danpeirce/photogate-box-ssd1306term/image/boards-mounted-bracket.jpg

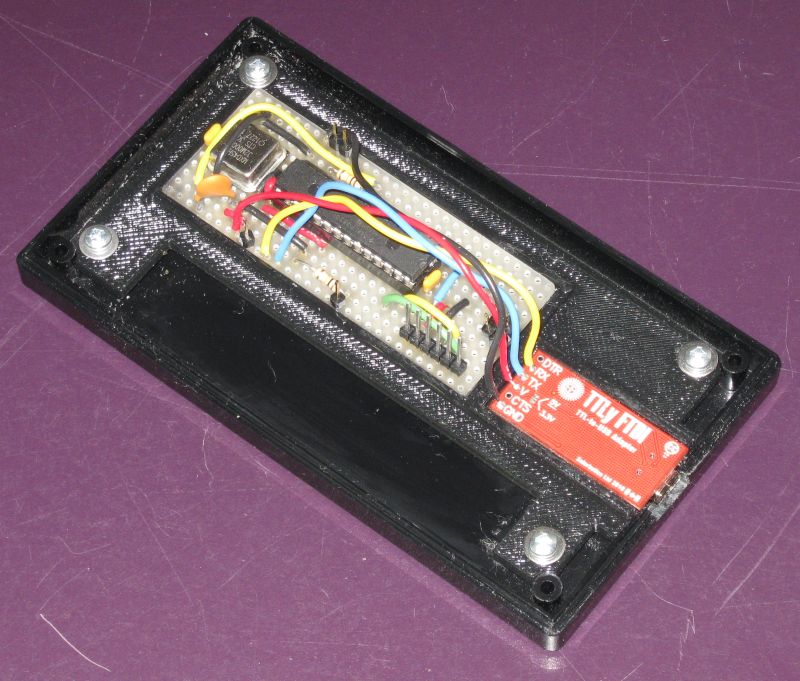
image/boards-mounted-bracket.jpg
