danpeirce/photogate-box-ssd1306term/image/keypress.jpg

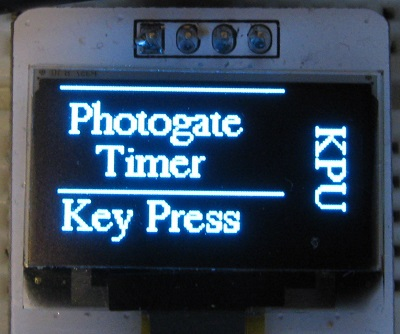
image/keypress.jpg
