danpeirce/photogate-box-ssd1306term/image/keyrelease.jpg

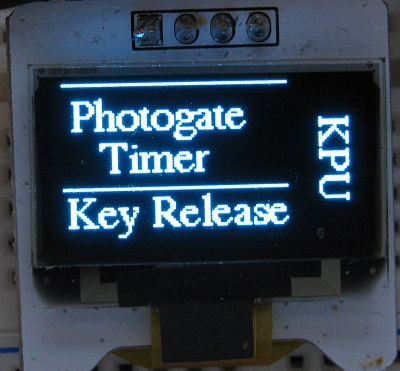
image/keyrelease.jpg
