danpeirce/photogate-box-ssd1306term/image/mancyclemode-s.png

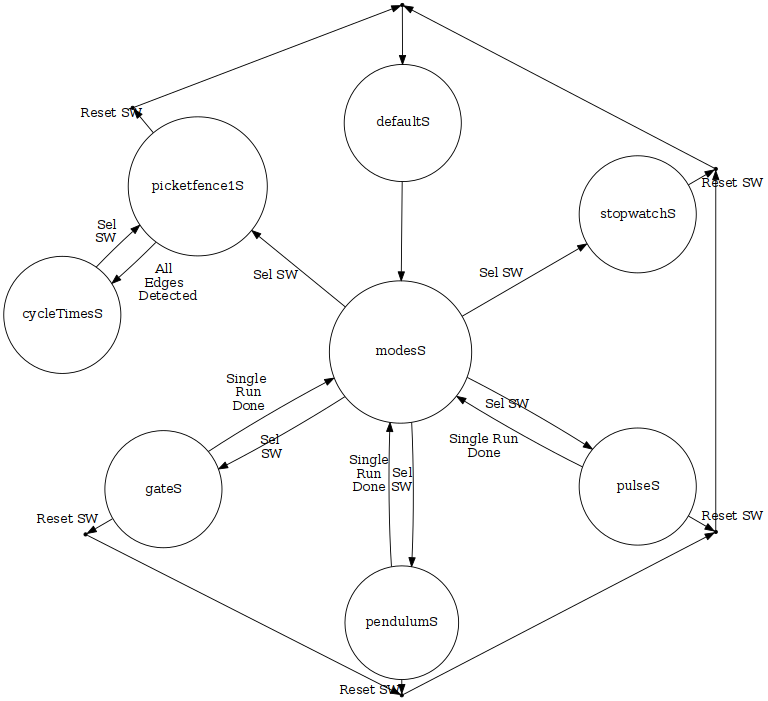
image/mancyclemode-s.png
