danpeirce/photogate-box-ssd1306term/image/mancyclemode.png

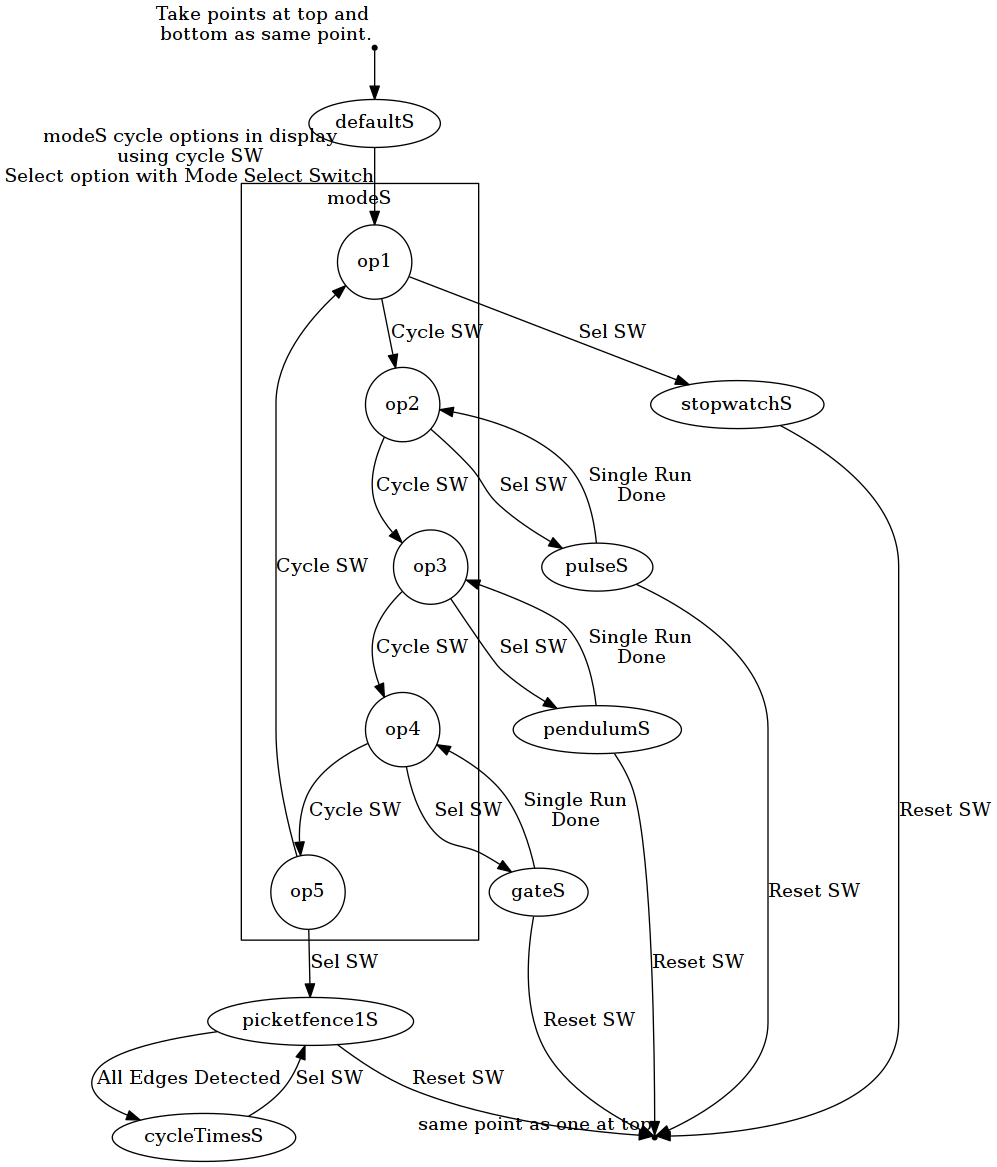
image/mancyclemode.png
