danpeirce/photogate-box-ssd1306term/image/terminal-in-box.jpg

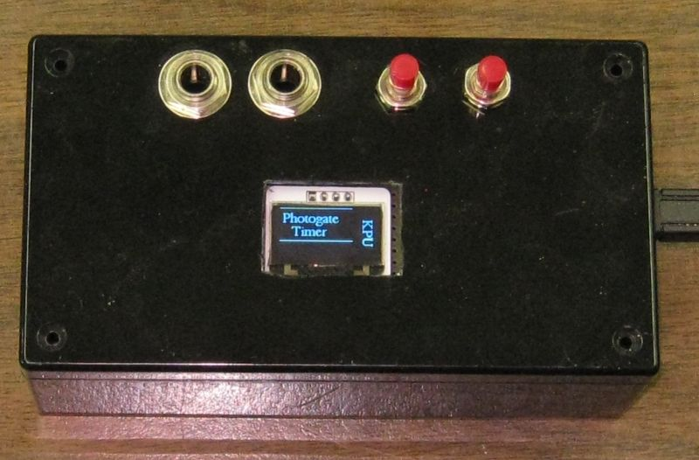
image/terminal-in-box.jpg
