danpeirce/photogate-box-ssd1306term/image/timeswitchsec.jpg

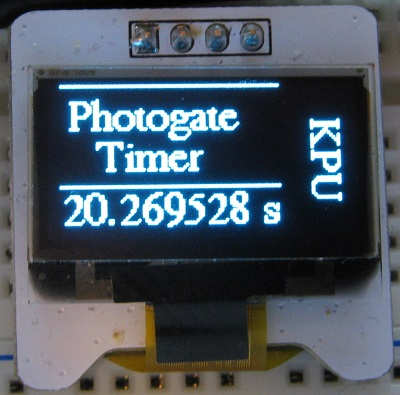
image/timeswitchsec.jpg
