danpeirce/photogate-box-ssd1306term/image/board_test01.jpg

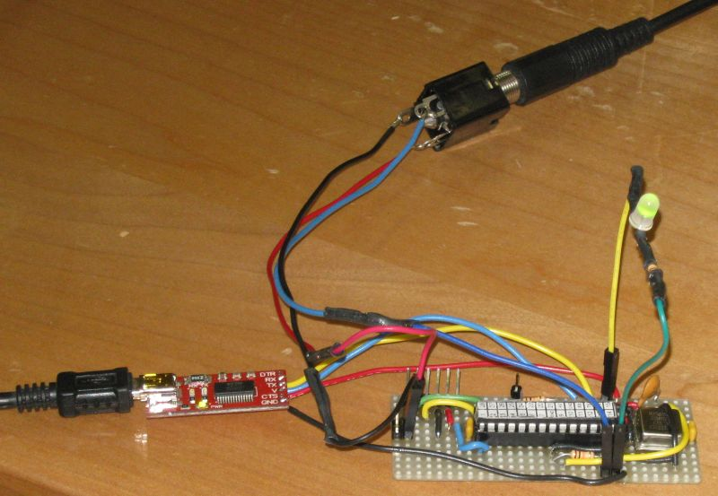
image/board_test01.jpg
