danpeirce/photogate-box-ssd1306term/(commit log)

2014-06-14 Moved LED outputs from Port D (wich does not exist) to port C
2014-06-14 Added image of board to readme.md
2014-06-16 Correction to PhotogateLV.c comments.
    Corrected pin numbers for CCP1 and CCP2 (the old numbers were for the PIC18F4525).
2014-06-16 new file pic18f2620.txt shows pin assignments
2014-06-23 modified: PhotogateLV.c on branch bugfix-timer
    Functions modified to use Timer1 and not Timer3
    * Time_AllEdges_2Gates()
    * Time_FallingEdges_2Gates()
    * C12_Increment_Counter_on_Timer_Rollover()
    The theory is the bug is as a result of Counter being
    incremented by both timers. It is not necessary to have
    more than one counter with both CPP modules as long as
    only one time scale is needed.
    The symtom was getting times reported as about twice they
    should have been when both CCP's were being used
    (like for the collision timer).
2014-06-27 Added photo to README.md
    Added photo of mounting plate used to attach the PCB's to the box lid.
2014-07-01 new files: host/nameVirtualCOM.py and host/photogate-timer.py
2014-07-01 modified: host/photogate-timer.py
    This file is still a work in progrss
    It does not do much yet!
2014-07-02 modified: photogate-timer.py reports time in seconds
2014-07-02 modified: doc/Time_AllEdges_1Gate.md
    Added link to photogate-timer.py
2014-07-06 modified: README.md - gate1.py - gate1_IPython.txt
    deleted: photogate-timer.py
    Note that ser.timeout = 0 so that reads from port are non blocking.
2014-07-10 modified: host/gate1gui.pyw
    Added run and exit buttons to GUI
2014-07-13 Moved images into repository
    modified: README.md
    new file: image/board_test01.jpg
    new file: image/box-gate.jpg
2014-07-13 modified: README.md new file: image/boards-mounted-bracket.jpg
2018-06-27 fixed link to 2006 timer_box project and other corrections
2018-06-29 removed image that does not reflect current project.
2018-07-03 Added char buffer and use sprintf()
    Added a buffer and used sprintf() to send text to the buffer.
    This removes the delays that result from the blocking printf().
    This new version is fast enough to catch a sifnificant amount
    of switch bounce that occures on some but not all edges.
    There are different methods to avoid bounce.
2018-07-03 slow down checking of switch status
2018-07-05 counts number times a pushbutton switch is pressed
    Useful for testing for switch bounce.
2018-07-24 Setup debounce switch in stopwatch
2018-07-30 reset mode switch/code added
2018-08-28 new images of prototype added
2018-08-30 Manually cycle modes with Mode Cycle/Reset Switch
2018-09-04 added memory feature to pulse mode
    The purpose of this feature is to allow one to retain and display
    the first timed duration and not have it overwritten by what comes
    later. One must again select Pulse mode with the select button.
    The memory feature is turned on by pressing the select button a second
    time (the first push on the select button sellects the mode the second
    press turns on the memory feature).
    If memory is on it will be indicated in the display.
2018-09-28 deleted DOC file not relevant to current project.
2018-09-28 deleted file not relevant to current project.
2019-04-03 Added PIC board images
2019-04-03 added images power-ground and switch-wiring
2019-04-04 Rotated power-ground.jpg
2019-04-04 added reset circuit schmatic
2023-12-01 added timer_m_SSD1306.hex
